charcole/NeoGeoHDMI/HDMIDirect.png

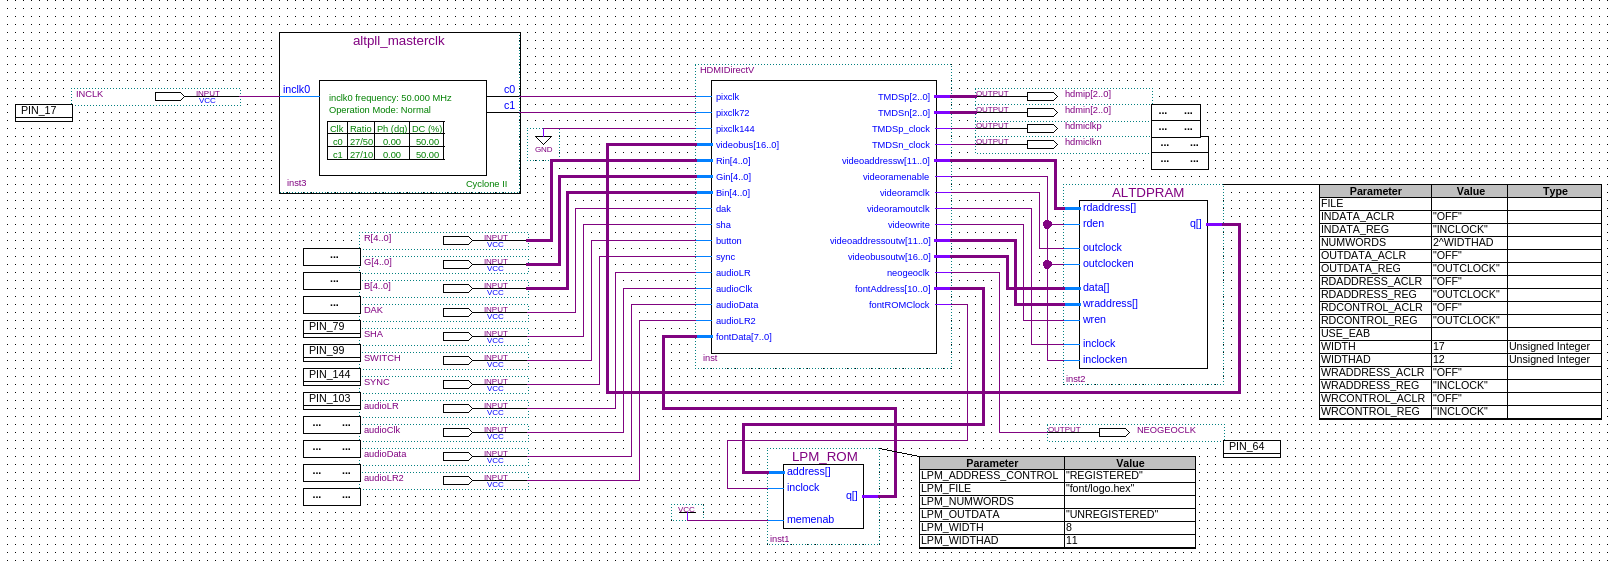
HDMIDirect.png
