charcole/NeoGeoHDMI/(commit log)

2015-01-12 Started out with fpga4fun.com's HDMI sample
2015-02-01 Workaround for TMDS encoder delay
2015-02-02 Made TMDS encoder two stage to avoid balance issues. Also improved button debounce
2015-02-11 Added information on the wiring
2015-02-15 Attached copy of GPL license
2015-03-15 Display current scanline mode + removed interlaced modes
2015-03-17 Fixed mistake on the YM3016 wiring information
2015-04-06 Fix to MV1-FS wiring
